mikhalych63/DAW00/daw00/daw00+analog.png

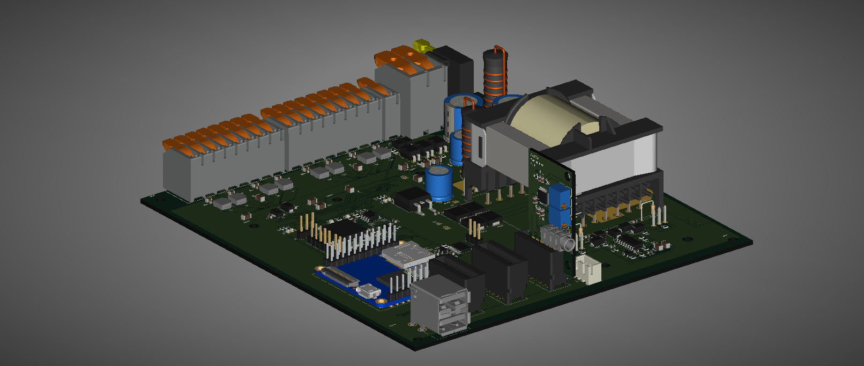
daw00/daw00+analog.png
