mikhalych63/DAW00/daw00/daw00+all.png

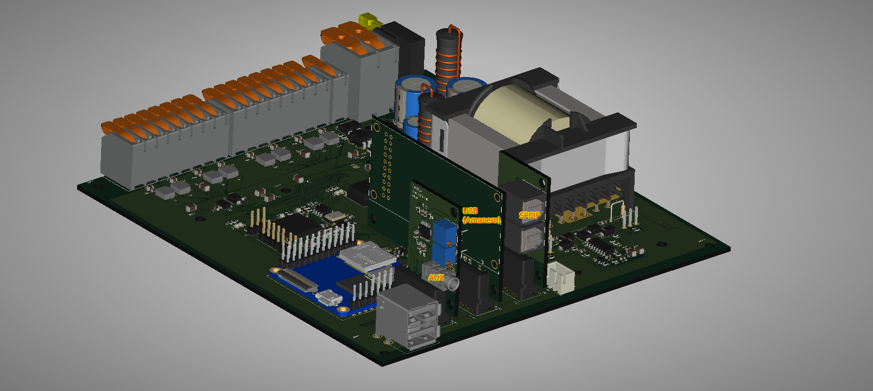
daw00/daw00+all.png
