mikhalych63/DAW00/daw00/daw00-3.png

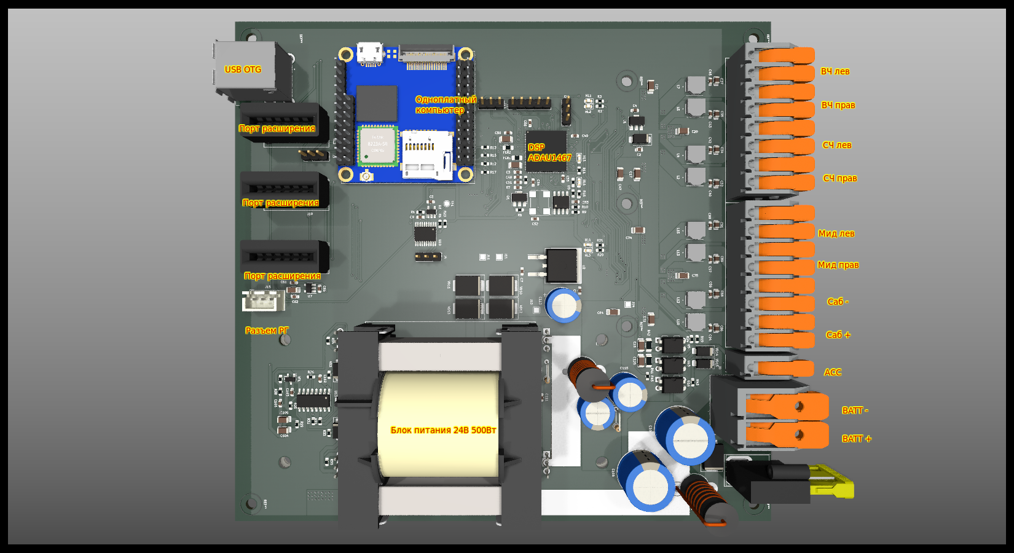
daw00/daw00-3.png
