mikhalych63/DAW00/daw00/daw00.1-2.png

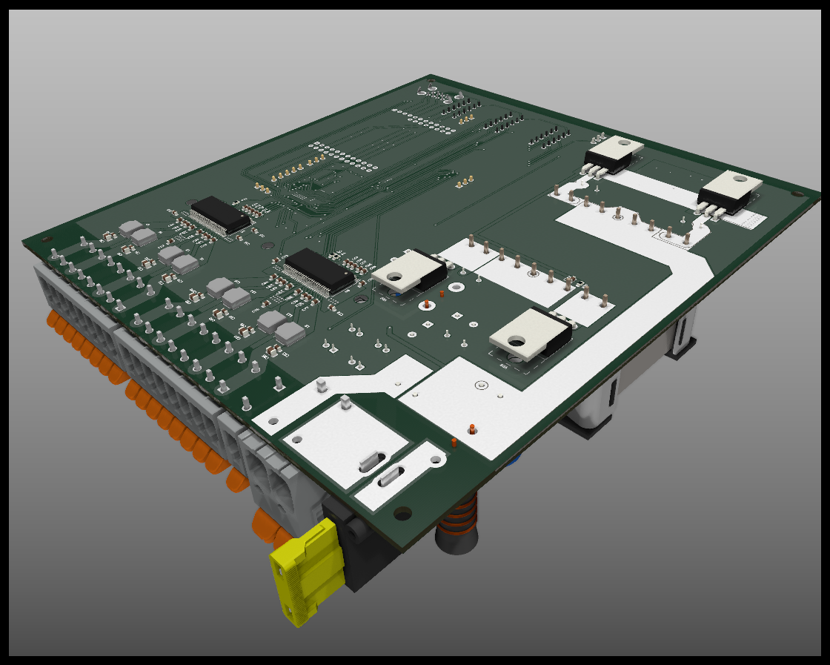
daw00/daw00.1-2.png
