mikhalych63/DAW00/daw00/daw00.png

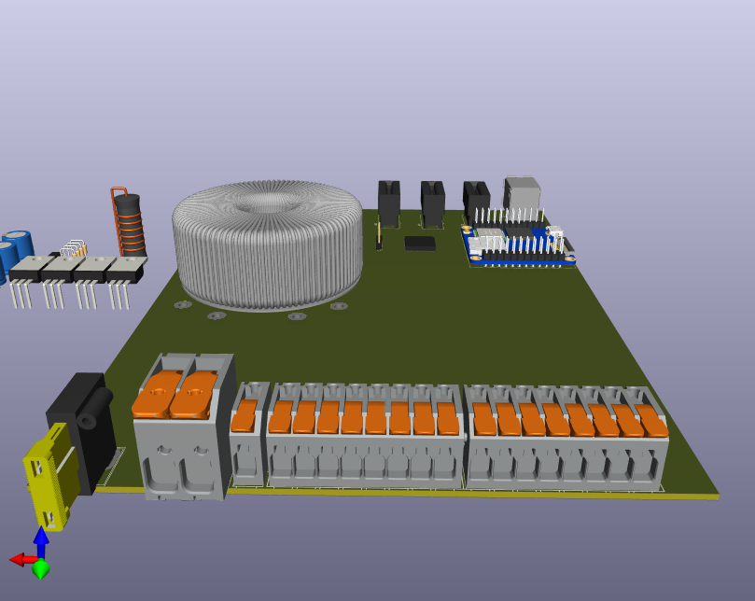
daw00/daw00.png
