mikhalych63/DAW00/daw00/enclosure/022_original.jpg

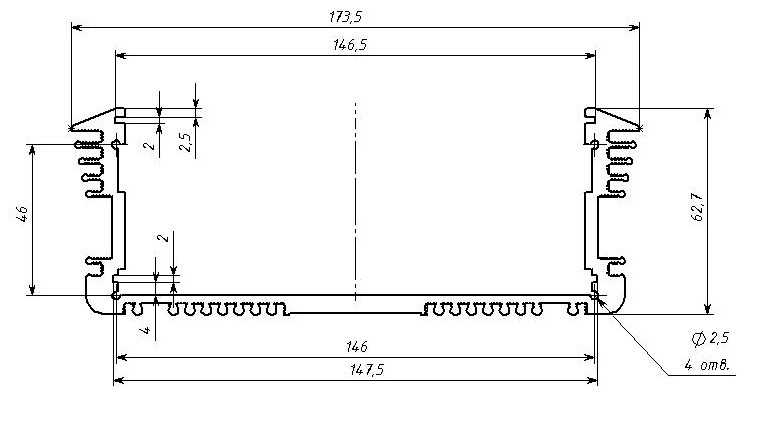
daw00/enclosure/022_original.jpg
