mikhalych63/DAW00/daw00/i2s_hdmi/I2S-HDMI.gif

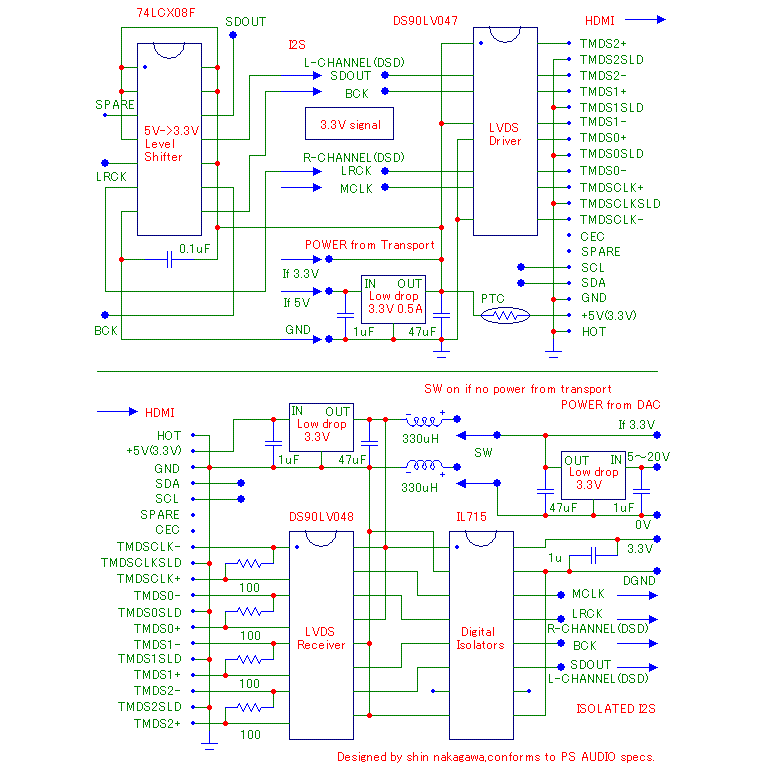
daw00/i2s_hdmi/I2S-HDMI.gif
