mikhalych63/DAW00/daw00/term.jpg

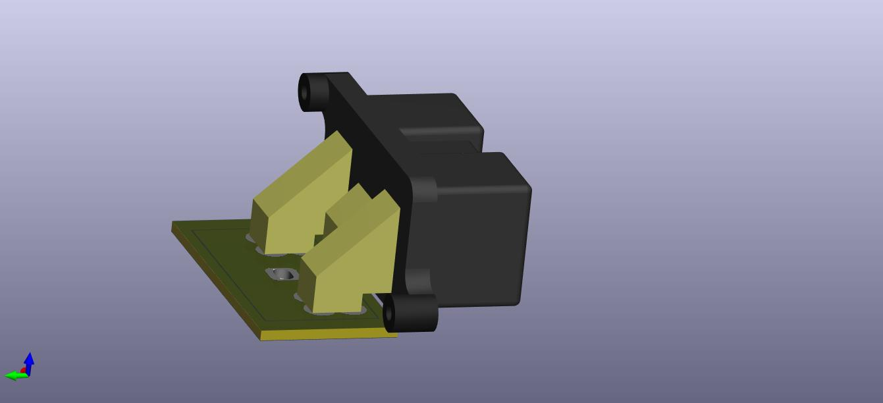
daw00/term.jpg
