mikhalych63/DAW00/daw00/Корпус1.png

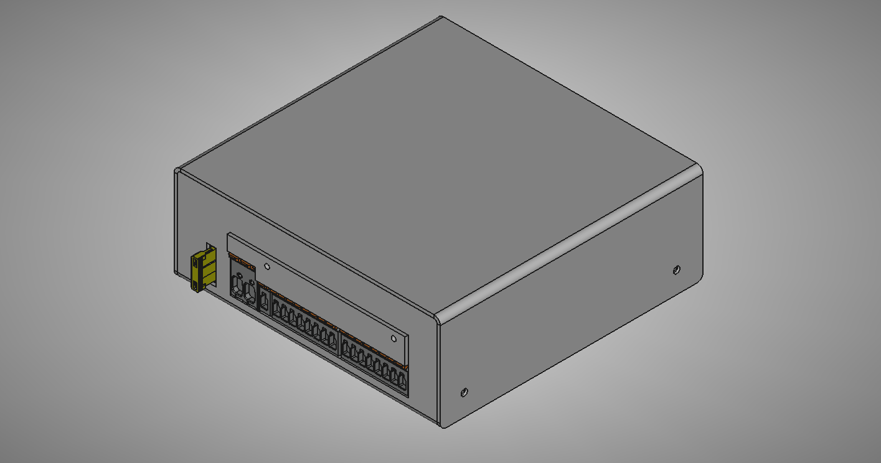
daw00/Корпус1.png
