mikhalych63/DAW00/daw00/Корпус2.png

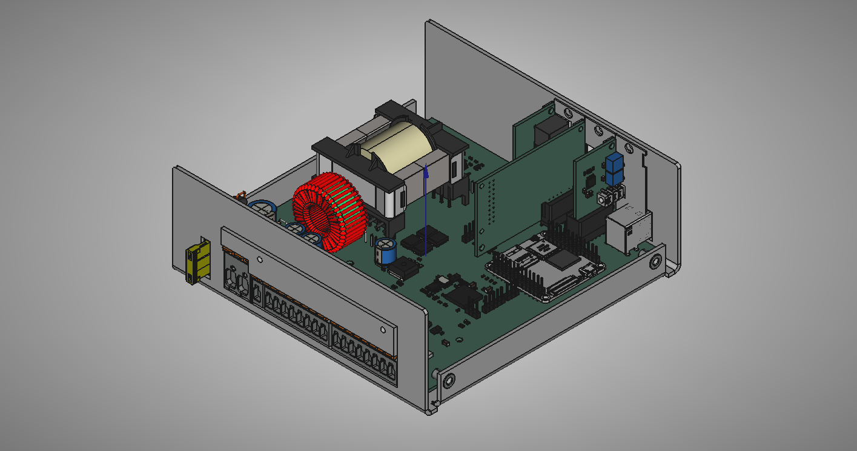
daw00/Корпус2.png
