mikhalych63/DAW00/daw00/Корпус3.png

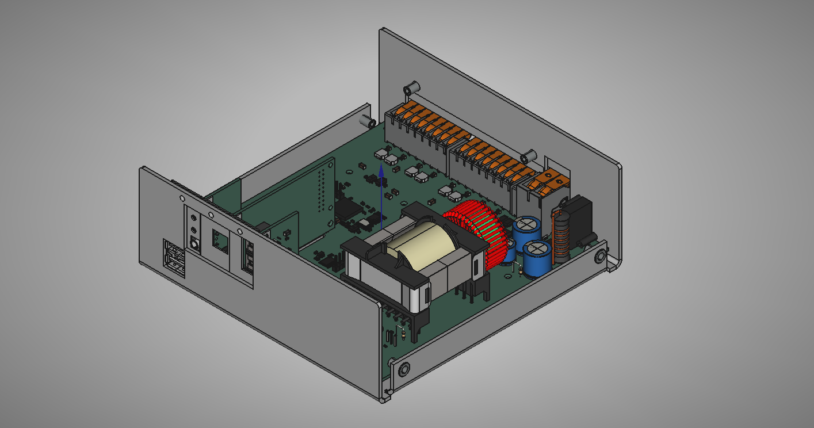
daw00/Корпус3.png
