mikhalych63/DAW00/daw00/Корпус 172*62.webp

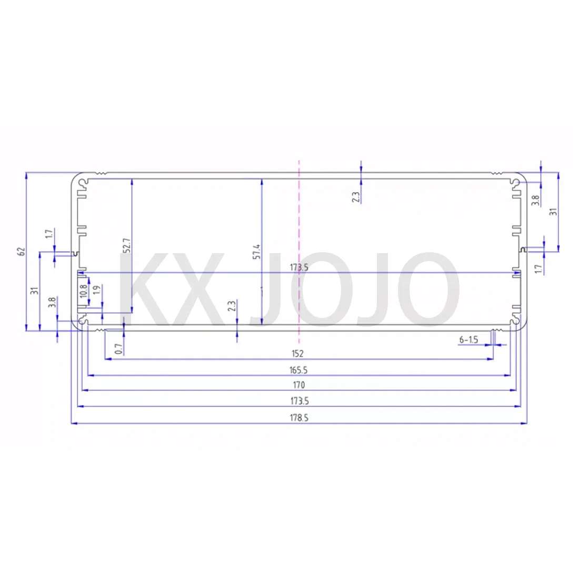
daw00/Корпус 172*62.webp
