mikhalych63/DAW00/daw00/bom/daw00.xlsx

Reference | Value | Footprint | Qty | Value1 | Цена | Сумма
C1,C6,C16,C17,C20,C21,C47,C63,C64,C71,C74,C75,C105,C125 | CAP_10u0_50V_X7R_1206 | Capacitor_SMD:C_1206_3216Metric | 14 | 10u | 5.2 | 72.8
C2,C7 | CAP_330n_50V_X7R_0603 | Capacitor_SMD:C_0603_1608Metric | 2 | 330n | 4 | 8
C3,C4,C5,C8,C9,C15,C18,C19,C22,C50,C53,C54,C55,C56,C57,C60,C62,C70,C72,C73,C76,C112 | CAP_100n_50V_X7R_0603 | Capacitor_SMD:C_0603_1608Metric | 22 | 100n | 2.5 | 55
C10,C11,C12,C13,C14,C23,C24,C25,C26,C27,C28,C29,C30,C31,C32,C33,C34,C35,C36,C37,C38,C65,C66,C67,C68,C69,C77,C78,C79,C80,C81,C82,C83,C84,C85,C86,C87,C88,C89,C90,C91,C92 | CAP_1u_50V_X7R_0603 | Capacitor_SMD:C_0603_1608Metric | 42 | 1u | 2.42 | 101.64
C39,C40,C41,C42,C43,C44,C45,C46,C49,C52,C61,C93,C94,C95,C96,C97,C98,C99,C100,C103,C106 | CAP_10n_50V_X7R_0603 | Capacitor_SMD:C_0603_1608Metric | 21 | 10n |  | 0
C48 | CAP_150p_50V_C0G_0603 | Capacitor_SMD:C_0603_1608Metric | 1 | 150p | 5 | 5
C51 | CAP_5n6_50V_X7R_0603 | Capacitor_SMD:C_0603_1608Metric | 1 | 5n6 | 5 | 5
C102,C111 | CAP_1n_50V_X7R_0603 | Capacitor_SMD:C_0603_1608Metric | 2 | 1n | 5 | 10
C104 | CAP_2u2_50V_X7R_1206 | Capacitor_SMD:C_1206_3216Metric | 1 | 2.2u | 5 | 5
C107,C108 | 2200μ | Capacitor_THT:CP_Radial_D14.0mm_P5.00mm | 2 | 2200u | 50 | 100
C109,C110 | CAP_22n_50V_X7R_0603 | Capacitor_SMD:C_0603_1608Metric | 2 | 22n | 5 | 10
C113,C114,C115 | CAP_330μ_35V | Capacitor_THT:CP_Radial_D10.0mm_P5.00mm | 3 | 330u | 30 | 90
F1 | Fuse | 00-mylib:Fuse_Blade_vertical | 1 |  | 170 | 170
FER1,FER2 | BLM21AG102SN1D | Resistor_SMD:R_0805_2012Metric_Pad1.20x1.40mm_HandSolder | 2 | 600R | 12 | 24
HL1,HL4 | LED_SMD_0603_YELLOW | LED_SMD:LED_0603_1608Metric | 2 |  | 15 | 30
HL2,HL3 | LED_SMD_0603_RED | LED_SMD:LED_0603_1608Metric | 2 |  | 15 | 30
HL5,HL6 | LED_SMD_0603_BLUE | LED_SMD:LED_0603_1608Metric_Pad1.05x0.95mm_HandSolder | 2 |  | 15 | 30
J2 | USB_A_Stacked | 00-mylib:USB_A_STACKED | 1 |  | 130 | 130
J6,J18 | DEGSON 2604 8x5 | Connector_Degson:DEGSON_8x5 | 2 |  | 130 | 260
J8 | DEGSON 2604 1x5 | Connector_Degson:DEGSON_1x5 | 1 |  | 30 | 30
J12,J19,J20 | Conn_edge_2x6_2.54_Male | Connector_Edge:2x6 | 3 |  | 100 | 300
J15 | Volume | Connector_JST:JST_XH_B3B-XH-A_1x03_P2.50mm_Vertical | 1 |  | 20 | 20
J22 | KF206-7.5-2P | Connector_Degson:DEGSON_2x7.5 | 1 |  | 160 | 160
L1,L2,L3,L4,L5,L6,L7,L8,L9,L10,L11,L12,L13,L14,L15,L16 | ETQP3M3R3KVP | my:SPM5010-5020 | 16 |  | 30 | 480
L18 | 5μ | my:L_Axial_L26.0mm_D9.0mm_P5.08mm_Vertical | 1 |  | 50 | 50
L19 | 25μ | 00-mylib:L_Toroid_Vertical_L33.0mm_W17.8mm_P12.70mm_Pulse_KM-5 | 1 |  | 50 | 50
Q1 | 2STF2360 | Package_TO_SOT_SMD:SOT-89-3 | 1 | 2STF2360 | 100 | 100
R1,R6,R23 | 10K | Resistor_SMD:R_0603_1608Metric | 3 |  | 1.5 | 4.5
R2,R3,R20,R21 | 1K | Resistor_SMD:R_0603_1608Metric | 4 |  | 1.5 | 6
R4,R5,R18,R22,R43 | 4.7K | Resistor_SMD:R_0603_1608Metric | 5 |  | 1.5 | 7.5
R7 | 4.3K | Resistor_SMD:R_0603_1608Metric | 1 | 4K3 | 1.5 | 1.5
R8,R24,R31,R32,R34,R35,R39,R45 | 1k | Resistor_SMD:R_0603_1608Metric | 8 | -- смешанные значения -- | 1.5 | 12
R9,R10,R11,R12,R13,R15,R17,R19 | 10k | Resistor_SMD:R_0603_1608Metric | 8 | -- смешанные значения -- | 1.5 | 12
R14,R16 | 510 | Resistor_SMD:R_0603_1608Metric | 2 | 510R | 1.5 | 3
R25 | 15k | Resistor_SMD:R_0603_1608Metric | 1 |  | 1.5 | 1.5
R26 | 150 | Resistor_SMD:R_0603_1608Metric | 1 |  | 1.5 | 1.5
R27 | 3k | Resistor_SMD:R_0603_1608Metric | 1 |  | 1.5 | 1.5
R28 | 3,6k | Resistor_SMD:R_0603_1608Metric | 1 |  | 1.5 | 1.5
R29,R30,R33 | 10 | Resistor_SMD:R_0603_1608Metric | 3 |  | 1.5 | 4.5
R36,R37 | 4.7 | Resistor_THT:R_Axial_DIN0204_L3.6mm_D1.6mm_P5.08mm_Vertical | 2 |  | 10 | 20
R38 | 100 | Resistor_THT:R_Axial_DIN0204_L3.6mm_D1.6mm_P5.08mm_Vertical | 1 |  | 10 | 10
R40 | 1.5k | Resistor_THT:R_Axial_DIN0204_L3.6mm_D1.6mm_P5.08mm_Vertical | 1 |  | 10 | 10
R41,R42 | 1.2k | Resistor_SMD:R_1206_3216Metric | 2 |  | 10 | 20
TR1 | TRANSF10 | 00-mylib:Transformer_ETD44_Horizontal | 1 |  | 500 | 500
U1 | L78L18_SOT89 | Package_TO_SOT_SMD:SOT-89-3 | 1 |  | 25 | 25
U2 | LD1086D2T33TR | Package_TO_SOT_SMD:TO-263-2 | 1 |  | 160 | 160
U3 | TPS3828-33DBVT | Package_TO_SOT_SMD:SOT-23-5 | 1 |  | 75 | 75
U4,U8 | TAS6424QDKQRQ1 | Package_SO:SSOP-56_7.5x18.5mm_P0.635mm | 2 |  | 300 | 600
U5,U15,U16 | TLP627 | Package_DIP:DIP-4_W7.62mm | 3 |  | 65 | 195
U6 | ADAU1467WBCPZ300RL | my:LFCSP-88-1EP_10x10mm_P0.5mm_EP6.15x6.15mm | 1 |  | 2500 | 2500
U7 | LP2985-5.0 | Package_TO_SOT_SMD:SOT-23-5 | 1 |  | 100 | 100
U9 | 25AA1024-I/SM | Package_SO:SOIC-8_3.9x4.9mm_P1.27mm | 1 | 25AA1024-I/SM | 500 | 500
U10 | STM32F030F4Px | Package_SO:TSSOP-20_4.4x6.5mm_P0.65mm | 1 |  | 75 | 75
U12 | Nanopi NEO Air | my:Nanopi NEO | 1 |  | 2500 | 2500
U13 | SG3525 | Package_SO:SOIC-16_3.9x9.9mm_P1.27mm | 1 |  | 50 | 50
VD1,VD10,VD11,VD12,VD13 | SS56 | Diode_SMD:D_SMC | 5 |  | 20 | 100
VD2 | ES1D | Diode_SMD:D_SMA | 1 |  | 15 | 15
VD3,VD4,VD5,VD14,VD15 | 1N5819 | Diode_SMD:D_SMA | 5 |  | 10 | 50
VD6,VD7 | 1N414E | Diode_SMD:D_SMA | 2 |  | 10 | 20
VD8,VD9 | MBR20100CT | Package_TO_SOT_THT:TO-220-3_Horizontal_TabUp | 2 |  | 30 | 60
VT1 | BC846 | Package_TO_SOT_SMD:SOT-23 | 1 |  | 20 | 20
VT2,VT3 | IRF3205 | Package_TO_SOT_THT:TO-220-3_Horizontal_TabUp | 2 |  | 35 | 70
X1 | SG-8002CA 24.5760M-PCBL3 | Oscillator:Oscillator_SMD_SeikoEpson_SG8002CA-4Pin_7.0x5.0mm | 1 |  | 350 | 350
Производство ПП |  |  | 1 |  | 800 | 800
Монтаж ПП |  |  | 1 |  | 2000 | 2000
Корпус |  |  | 1 |  | 2000 | 2000
 |  |  |  |  |  | 0
 |  |  |  |  |  | 15208.44
