mikhalych63/DAW00/daw00/amanero/amanero.step

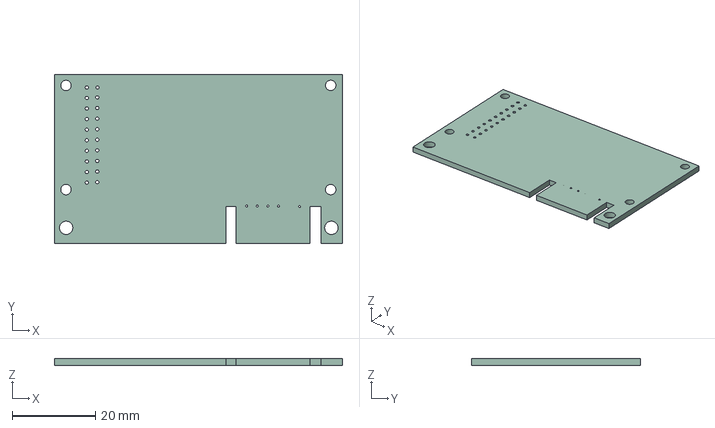
[picture p16: CAD file, 2024-03-14]
daw00/amanero/amanero.step
69.1 x 40.6 x 1.60 mm
