mikhalych63/DAW00/daw00/Enlosure/body.step

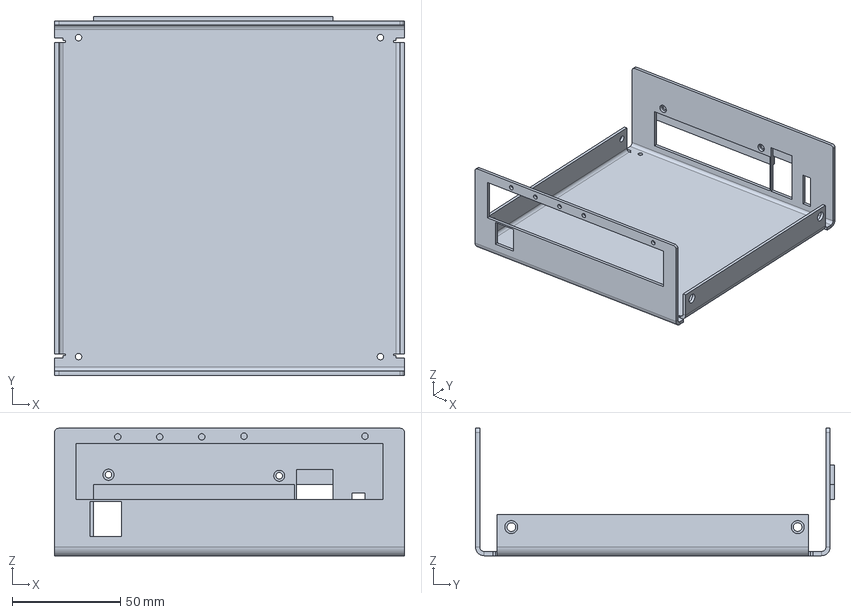
[picture p17: CAD file, 2024-03-20]
daw00/Enlosure/body.step
162.0 x 166.1 x 59.0 mm
