mikhalych63/DAW00/daw00/spdif/spdif.step

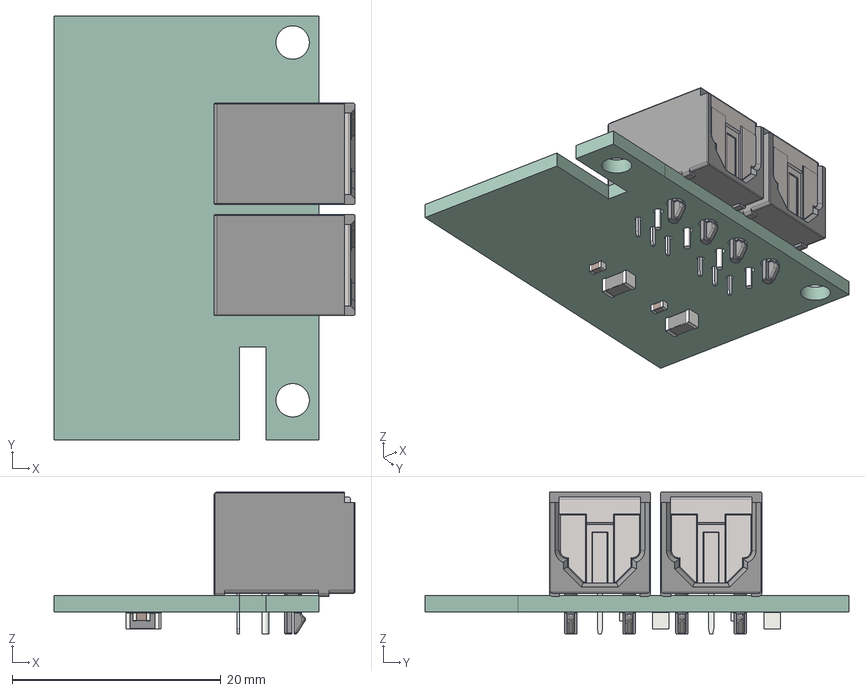
[picture p18: CAD file, 2024-03-20]
daw00/spdif/spdif.step
28.8 x 40.6 x 13.6 mm
User Library-TORX147PL(f,t) x 2
L_1206_3216Metric x 2
C_0603_1608Metric x 2
spdif_PCB
