mikhalych63/DAW00/daw00/daw00.FCStd

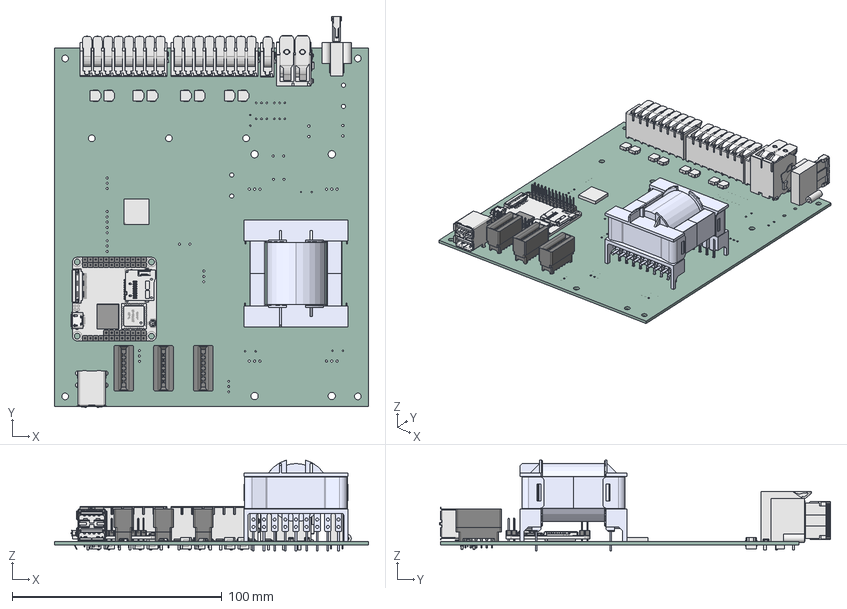
[picture p19: CAD file, 2024-02-22]
daw00/daw00.FCStd
149.9 x 186.7 x 43.4 mm
Tube001
Tube
Нога2
Нога1
Куб
fuse_automotive_10a001
fuse_automotive_10a
CAD_SPM5020-LR
ETD 44
ETD 045
ETD 046
ETD 047
ETD 048
ETD 049
ETD 050
ETD 051
ETD 052
ETD 053
ETD 054
ETD 055
ETD 056
ETD 057
ETD 058
ETD 059
ETD 060
ETD 061
ETD 062
ETD 063
ETD 064
ETD 065
ETD 066
ETD 067
CAD_SPM5020-LR001
CAD_SPM5020-LR002
CAD_SPM5020-LR003
C-5787745-4
CAD_SPM5020-LR004
CAD_SPM5020-LR005
NanoPi-NEO-Air-ASSY
NanoPi-NEO-Air-ASSY001
NanoPi-NEO-Air-ASSY002
NanoPi-NEO-Air-ASSY003
NanoPi-NEO-Air-ASSY004
NanoPi-NEO-Air-ASSY005
NanoPi-NEO-Air-ASSY006
NanoPi-NEO-Air-ASSY007
NanoPi-NEO-Air-ASSY008
NanoPi-NEO-Air-ASSY009
NanoPi-NEO-Air-ASSY010
NanoPi-NEO-Air-ASSY011
NanoPi-NEO-Air-ASSY012
NanoPi-NEO-Air-ASSY013
NanoPi-NEO-Air-ASSY014
NanoPi-NEO-Air-ASSY015
NanoPi-NEO-Air-ASSY016
NanoPi-NEO-Air-ASSY017
NanoPi-NEO-Air-ASSY018
NanoPi-NEO-Air-ASSY019
NanoPi-NEO-Air-ASSY020
NanoPi-NEO-Air-ASSY021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
