mikhalych63/DAW00/daw00/Enlosure/cap.step

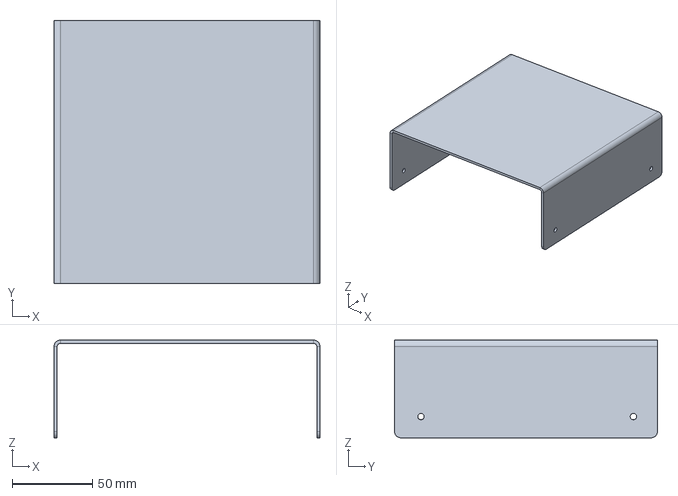
[picture p20: CAD file, 2024-03-20]
daw00/Enlosure/cap.step
166.0 x 164.0 x 61.0 mm
