mikhalych63/DAW00/(list of files, cad)

Other CAD files:
daw00/1.FCStd
daw00/analog_input/analog-input.FCStd
daw00/Enlosure/body.FCStd
daw00/Enlosure/body.SLDPRT
daw00/Enlosure/cap.FCStd
daw00/Enlosure/cap.SLDPRT
