mikhalych63/DAW00/daw00/daw00.kicad_pcb

## KiCad design daw00/daw00.kicad_pcb (2024-03-20)

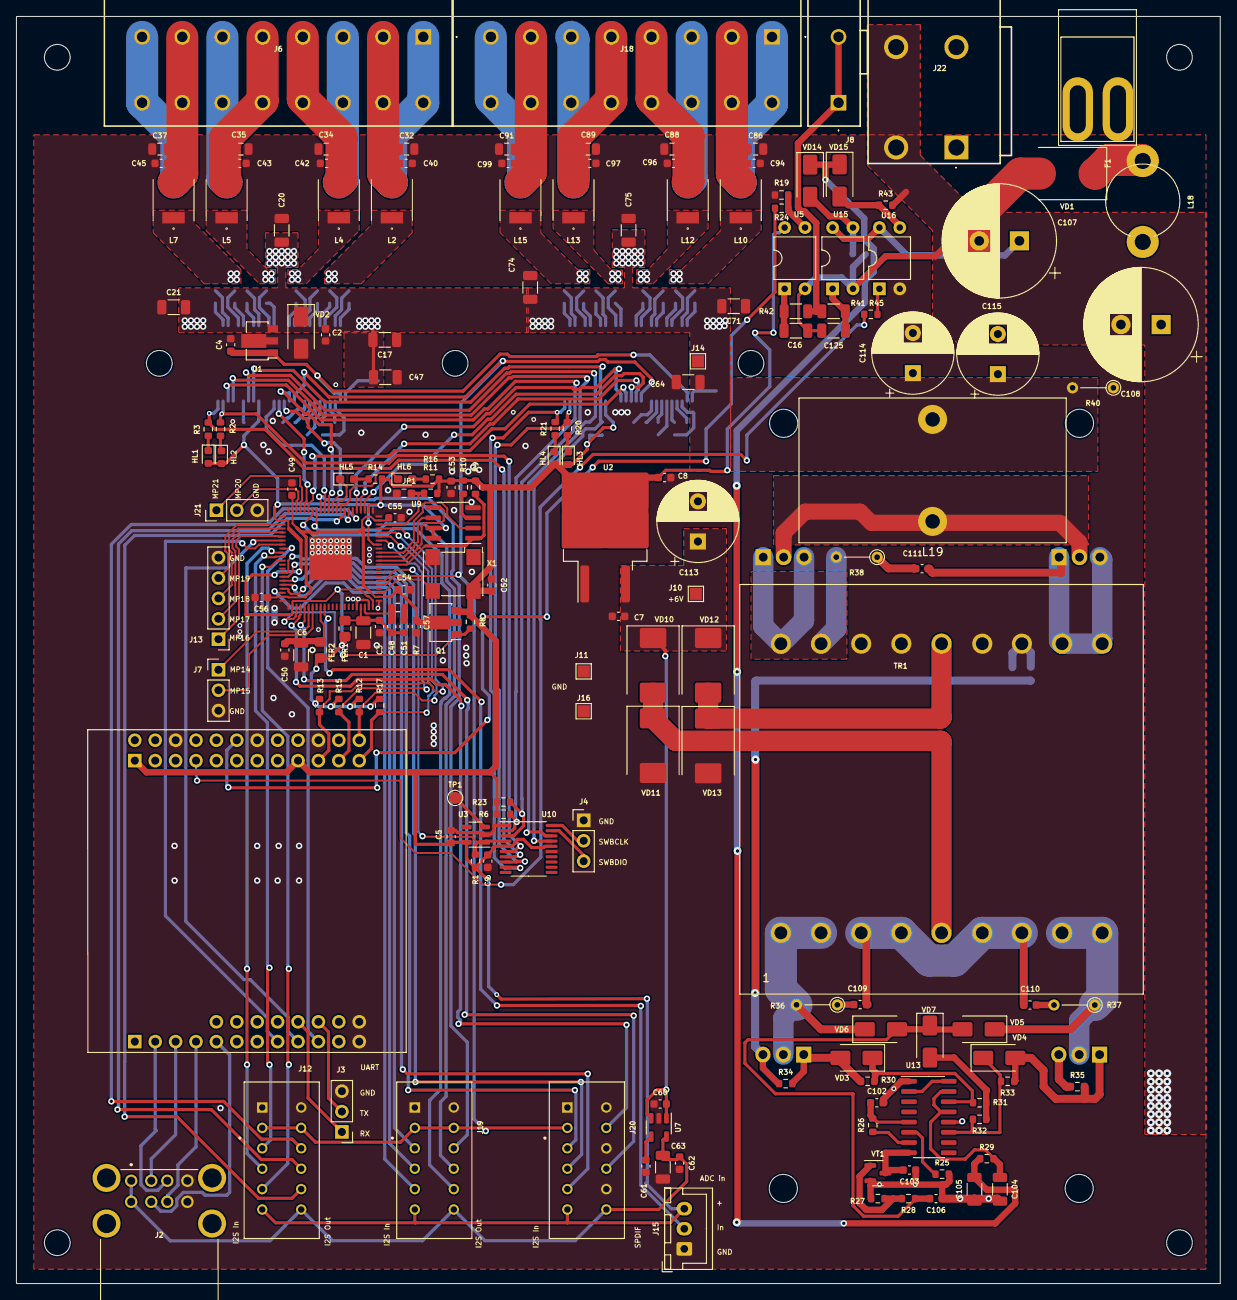
[picture p21: board daw00.kicad_pcb from above]

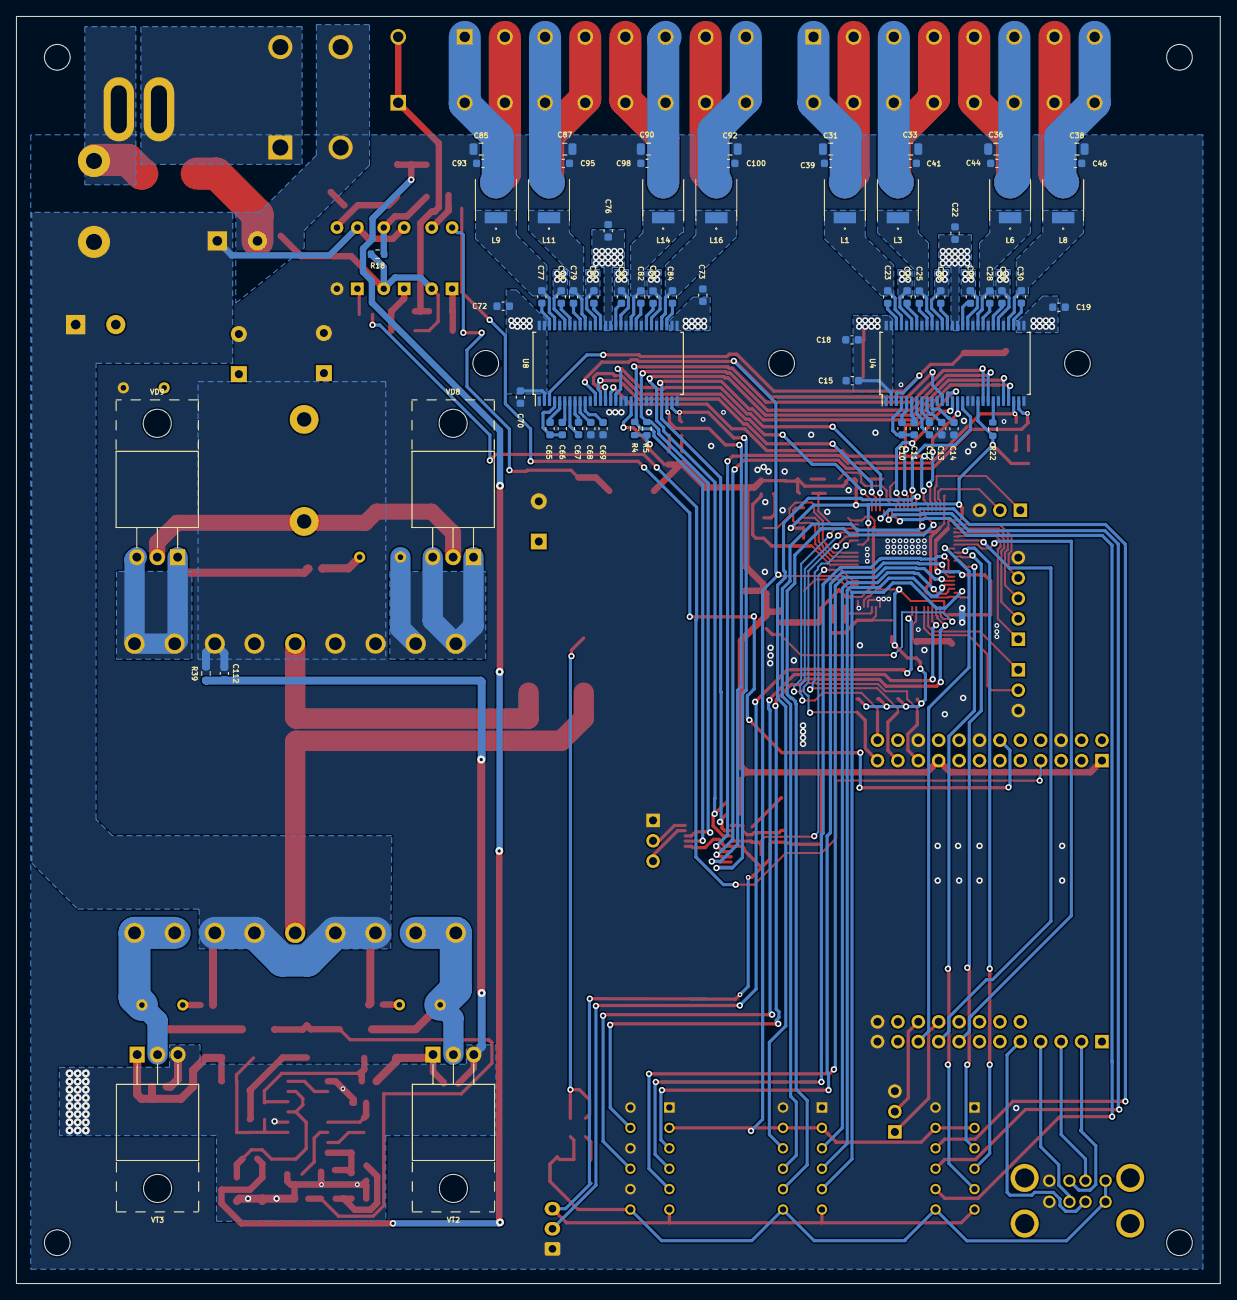
[picture p22: board daw00.kicad_pcb from below]

Board: 2 copper layers, 149.9 x 157.7 mm, 239 parts (70 on the bottom side), 188 nets.

Parts:
C1, C6, C16, C105, C125: CAP_10u0_50V_X7R_1206; C_1206_3216Metric
C2, C7: 0,33uF; C_0603_1608Metric
C3, C5, C50, C53, C54, C55, C56, C57, C112: CAP_100n_50V_X7R_0603; C_0603_1608Metric
C4, C8, C9, C15, C18, C19, C22, C60, C62, C70, C72, C73, C76: 100n; C_0603_1608Metric
C10, C11, C12, C13, C14, C23, C24, C25, C26, C27, C28, C29, C30, C65, C66, C67, C68, C69, C77, C78, C79, C80, C81, C82, C83, C84: 1,0uF; C_0603_1608Metric
C17, C20, C21, C47, C63, C64, C71, C74, C75: 10,0uF; C_1206_3216Metric
C31, C32, C33, C34, C35, C36, C37, C38, C85, C86, C87, C88, C89, C90, C91, C92: 1.0uF; C_0805_2012Metric
C39, C40, C41, C42, C43, C44, C45, C46, C61, C93, C94, C95, C96, C97, C98, C99, C100: 10n; C_0603_1608Metric
C48: CAP_150p_50V_C0G_0603; C_0603_1608Metric
C49, C103, C106: CAP_10n_50V_X7R_0603; C_0603_1608Metric
C51: CAP_5n6_50V_X7R_0603; C_0603_1608Metric
C52: CAP_10n_25V_X7R_0603; C_0603_1608Metric
C102, C111: CAP_1n_50V_X7R_0603; C_0603_1608Metric
C104: CAP_2u2_50V_X7R_1206; C_1206_3216Metric
C107, C108: 2200μ; CP_Radial_D14.0mm_P5.00mm
C109, C110: CAP_22n_50V_X7R_0603; C_0603_1608Metric
C113, C114, C115: 330μ; CP_Radial_D10.0mm_P5.00mm
F1: Fuse; Fuse_Blade_vertical
FER1, FER2: BLM21AG102SN1D; R_0805_2012Metric_Pad1.20x1.40mm_HandSolder
HL1, HL4: LED_SMD_0603_YELLOW; LED_0603_1608Metric
HL2, HL3: LED_SMD_0603_RED; LED_0603_1608Metric
HL5, HL6: LED_SMD_0603_BLUE; LED_0603_1608Metric_Pad1.05x0.95mm_HandSolder
J2: USB_A_Stacked; USB_A_STACKED
J3: UART; PinHeader_1x03_P2.54mm_Vertical
J4: SWD; PinHeader_1x03_P2.54mm_Vertical
J6, J18: DEGSON 2604 8x5; DEGSON_8x5
J7, J21: Conn_01x02_Male; PinHeader_1x03_P2.54mm_Vertical
J8: DEGSON 2604 1x5; DEGSON_1x5
J10: +6V; TestPoint_Pad_1.5x1.5mm
J11, J16: GND; TestPoint_Pad_1.5x1.5mm
J12, J19, J20: Conn_edge_2x6_2.54_Male; 2x6
J13: Conn_01x04_Male; PinHeader_1x05_P2.54mm_Vertical
J14: +24V; TestPoint_Pad_1.5x1.5mm
J15: Volume; JST_XH_B3B-XH-A_1x03_P2.50mm_Vertical
J22: KF206-7.5-2P; DEGSON_2x7.5
JP1: CON_JUMPER; R_0603_1608Metric_Pad0.98x0.95mm_HandSolder
L1, L2, L3, L4, L5, L6, L7, L8, L9, L10, L11, L12, L13, L14, L15, L16: 3.3uH; SPM5010-5020
L18: 5μ; L_Axial_L26.0mm_D9.0mm_P5.08mm_Vertical
L19: 25μ; L_Toroid_Vertical_L33.0mm_W17.8mm_P12.70mm_Pulse_KM-5
Q1: 2STF2360; SOT-89-3
R1, R6, R23: 10K; R_0603_1608Metric
R2, R3, R20, R21: 1K; R_0603_1608Metric
R4, R5, R22: 4k7; R_0603_1608Metric
R7: RES_4K3_1%_0.125W_Thick_0603; R_0603_1608Metric
R8: RES_1K0_1%_0.125W_Thick_0603; R_0603_1608Metric
R9, R10, R11, R12, R13, R15, R17: RES_10K0_1%_0.125W_Thick_0603; R_0603_1608Metric
R14, R16: RES_51R0_1%_0.125W_Thick_0603; R_0603_1608Metric
R18, R43: 4.7k; R_0603_1608Metric
R19: 10k; R_0603_1608Metric
R24, R31, R32, R34, R35, R39, R45: 1k; R_0603_1608Metric
R25: 15k; R_0603_1608Metric
R26: 150; R_0603_1608Metric
R27: 3k; R_0603_1608Metric
R28: 3,6k; R_0603_1608Metric
R29, R30, R33: 10; R_0603_1608Metric
R36, R37: 4.7; R_Axial_DIN0204_L3.6mm_D1.6mm_P5.08mm_Vertical
R38: 100; R_Axial_DIN0204_L3.6mm_D1.6mm_P5.08mm_Vertical
R40: 1.5k; R_Axial_DIN0204_L3.6mm_D1.6mm_P5.08mm_Vertical
R41, R42: 1.2k; R_1206_3216Metric
TP1: Reset; TestPoint_Pad_D1.5mm
TR1: TRANSF10; Transformer_ETD44_Horizontal
U1: L78L18_SOT89; SOT-89-3
U2: LD1086D2T33TR; TO-263-2
U3: TPS3828-33DBVT; SOT-23-5
U4, U8: TAS6424QDKQRQ1; SSOP-56_7.5x18.5mm_P0.635mm
U5, U15, U16: TLP627; DIP-4_W7.62mm
U6: ADAU1467WBCPZ300RL; LFCSP-88-1EP_10x10mm_P0.5mm_EP6.15x6.15mm
U7: LP2985-5.0; SOT-23-5
U9: 25AA1024-I/SM; SOIC-8_3.9x4.9mm_P1.27mm
U10: STM32F030F4Px; TSSOP-20_4.4x6.5mm_P0.65mm
U12: Nanopi NEO Air; Nanopi NEO
U13: SG3525; SOIC-16_3.9x9.9mm_P1.27mm
VD1, VD10, VD11, VD12, VD13: SS56; D_SMC
VD2: ES1D; D_SMA
VD3, VD4, VD5, VD14, VD15: 1N5819; D_SMA
VD6, VD7: 1N414E; D_SMA
VD8, VD9: MBR20100CT; TO-220-3_Horizontal_TabUp
VT1: BC846; SOT-23
VT2, VT3: IRF3205; TO-220-3_Horizontal_TabUp
X1: SG-8002CA 24.5760M-PCBL3; Oscillator_SMD_SeikoEpson_SG8002CA-4Pin_7.0x5.0mm

Connections:
+3V3: C5.2, C8.1, C9.2, C52.1, C53.1, FER1.2, FER2.2, HL1.2 (A), HL2.2 (A), HL3.2 (A), HL4.2 (A), J12.11, J15.3, J19.11, J20.11, Q1.3 (E), R1.1, R4.1, R5.1, R6.1, R8.2, R9.1, R10.1, R11.1, R12.1, R13.1, R14.1, R15.1, R16.1, R17.1, R22.2, R23.1, U2.2 (OUT), U3.5 (VDD), U4.19 (VDD), U5.4, U6.2 (IOVDD), U6.22 (IOVDD), U6.37 (IOVDD), U6.46 (IOVDD), U6.68 (IOVDD), U8.19 (VDD), U9.7 (~HOLD), U9.8 (VCC), U10.5 (VDDA), U10.16 (VDD), U12.1 (VDD_3.3V), U12.17 (VDD_3.3V), X1.4 (Vcc)
+5V: C62.2, C63.1, J2.1 (VBUS1), J2.5 (VBUS2), J12.12, J19.12, J20.12, U7.5 (VOUT)
+6V: C7.1, C60.2, C113.1, J10.1, U2.3 (IN), U7.1 (VIN), U7.3 (ON/~OFF), VD10.1 (K), VD12.1 (K)
+BATT: F1.1, J22.1
/Amplifier/AUXADC0: J15.2, U6.10 (AUXADC0)
/Amplifier/BCLKIN1: J12.7, U6.76 (BCLK_IN1)
/Amplifier/BCLKIN2: J20.7, U6.81 (BCLK_IN2)
/Amplifier/BCLKIN3: J19.7, U6.84 (BCLK_IN3)
/Amplifier/BCLKOUT0: U6.48 (BCLK_OUT0), U8.13 (SCLK)
/Amplifier/BCLKOUT1: J12.8, U6.51 (BCLK_OUT1)
/Amplifier/BCLKOUT2: U4.13 (SCLK), U6.56 (BCLK_OUT2)
/Amplifier/BCLKOUT3: J19.8, U6.59 (BCLK_OUT3)
/Amplifier/LRCKIN1: J12.5, U6.77 (LRCLK_IN1/MP11)
/Amplifier/LRCKIN2: J20.5, U6.82 (LRCLK_IN2/MP12)
/Amplifier/LRCKIN3: J19.5, U6.85 (LRCLK_IN3/MP13)
/Amplifier/LRCKOUT1: J12.6, U6.50 (LRCLK_OUT1/MP5)
/Amplifier/LRCKOUT3: J19.6, U6.58 (LRCLK_OUT3/MP9)
/Amplifier/LRCLKOUT0: U6.47 (LRCLK_OUT0/MP4), U8.14 (FSYNC)
/Amplifier/LRCLKOUT2: U4.14 (FSYNC), U6.55 (LRCLK_OUT2/MP8)
/Amplifier/SDATAIN1: J12.9, U6.78 (SDATA_IN1)
/Amplifier/SDATAIN2: J20.9, U6.83 (SDATA_IN2)
/Amplifier/SDATAIN3: J19.9, U6.86 (SDATA_IN3)
/Amplifier/SDATAOUT0: U6.49 (SDATA_OUT0), U8.16 (SDIN2)
/Amplifier/SDATAOUT1: J12.10, U6.52 (SDATA_OUT1)
/Amplifier/SDATAOUT1+: U6.61 (SDATAIO7/MP23), U8.15 (SDIN1)
/Amplifier/SDATAOUT2: U4.16 (SDIN2), U6.57 (SDATA_OUT2)
/Amplifier/SDATAOUT3: J19.10, U6.60 (SDATA_OUT3)
/Amplifier/SDATAOUT3+: U4.15 (SDIN1), U6.62 (SDATAIO6/MP22)
/Amplifier/SPDIFIN: J20.4, U6.4 (SPDIFIN)
/Amplifier/SPDIFOUT: J20.8, U6.5 (SPDIFOUT)
/Computer/SBWTCK: J4.2, U10.20 (PA14)
/Computer/SBWTDIO: J4.3, U10.19 (PA13)
ACC: J8.1, R41.2, R42.2
ACC_IN: R24.2, U12.12 (GPIO_A6)
BCLKIN0: U6.73 (BCLK_IN0), U12.39 (I2S0_BCK)
FAULT0: R21.2, U8.27 (FAULT), U10.9 (PA3)
FAULT1: R3.2, U4.27 (FAULT), U10.7 (PA1)
GND: C1.2, C2.2, C3.2, C4.2, C5.1, C6.2, C7.2, C8.2, C9.1, C13.2, C14.2, C15.1, C17.1, C18.1, C19.1, C20.2, C21.1, C22.2, C31.1, C32.2, C33.1, C34.2, C35.1, C36.2, C37.1, C38.2, C39.1, C40.2, C41.1, C42.2, C43.1, C44.2, C45.1, C46.2, C47.1, C49.2, C50.2, C52.2, C53.2, C54.2, C55.2, C56.2, C57.2, C60.1, C61.1, C62.1, C63.2, C64.1, C68.2, C69.2, C70.1, C71.1, C72.1, C73.1, C74.2, C75.1, C76.2, C85.1, C86.2, C87.1, C88.2, C89.1, C90.2, C91.1, C92.2, C93.1, C94.2, C95.1, C96.2, C97.1, C98.2, C99.1, C100.2, C112.1, C113.2, C114.2, C115.2, J2.4 (GND1), J2.8 (GND2), J3.3, J4.1, J7.3, J11.1, J12.1, J12.2, J13.5, J15.1, J16.1, J19.1, J19.2, J20.1, J20.2, J20.6, J20.10, J21.3, JP1.2, R19.2, R39.2, R40.1, TR1.6, TR1.7, U1.2 (GND), U2.1 (ADJ/GND), U3.2 (GND), U4.1 (GND), U4.11 (GND), U4.17 (GND), U4.18 (GND), U4.23 (I2C_ADDR1), U4.28 (GND), U4.33 (GND), U4.36 (GND), U4.39 (GND), U4.46 (GND), U4.49 (GND), U4.52 (GND), U6.1 (DGND), U6.8 (AGND), U6.18 (PGND), U6.21 (DGND), U6.23 (DGND), U6.29 (DGND), U6.36 (DGND), U6.44 (DGND), U6.45 (DGND), U6.66 (DGND), U6.67 (DGND), U6.88 (DGND), U6.89 (GND), U7.2 (GND), U8.1 (GND), U8.11 (GND), U8.17 (GND), U8.18 (GND), U8.22 (I2C_ADDR0), U8.23 (I2C_ADDR1), U8.28 (GND), U8.33 (GND), U8.36 (GND), U8.39 (GND), U8.46 (GND), U8.49 (GND), U8.52 (GND), U9.4 (VSS), U10.1 (BOOT0), U10.15 (VSS), U12.6 (GND), U12.14 (GND), U12.20 (GND), U12.42 (GND), U12.50 (GND), U16.2, VD2.2 (A), VD11.2 (A), VD13.2 (A), X1.2 (GND)
GNDPWR: C16.2, C102.2, C103.1, C104.2, C105.2, C106.1, C107.2, C108.2, C112.2, C125.2, J22.2, R18.2, R25.2, R27.1, R34.1, R35.1, R39.1, R43.2, U5.2, U13.1 (INV), U13.12 (GND), U15.2, VD1.2 (A), VT1.2 (E), VT2.3 (S), VT3.3 (S)
LRCKIN0: U6.74 (LRCLK_IN0/MP10), U12.38 (I2S0_LRCK)
MCLK: J12.3, J12.4, J19.3, J19.4, J20.3, U4.12 (MCLK), U6.27 (CLKOUT), U8.12 (MCLK)
MISO: R15.2, U6.38 (MISO/SDA), U12.21 (SPI0_MISO)
MOSI: R13.2, U6.41 (SS/ADDR0), U12.19 (SPI0_MOSI)
Mute: R23.2, U4.24 (MUTE), U8.24 (MUTE), U10.3 (PF1)
unnamed: C13.1, U4.9 (GVDD)
unnamed: C14.1, U4.10 (GVDD)
unnamed: C16.1, R42.1, U5.1
unnamed: C51.2, R7.2
unnamed: C68.1, U8.9 (GVDD)
unnamed: C69.1, U8.10 (GVDD)
unnamed: C107.1, C108.1, C109.2, C110.1, L18.2, TR1.2, TR1.3, U15.4, U16.4
unnamed: C109.1, R36.1
unnamed: C110.2, R37.2
unnamed: C111.1, R38.1
unnamed: C125.1, R41.1, U15.1
unnamed: HL1.1 (K), R3.1
unnamed: HL2.1 (K), R2.2
unnamed: HL3.1 (K), R20.2
unnamed: HL4.1 (K), R21.1
unnamed: HL5.2 (A), R14.2
unnamed: HL5.1 (K), U6.54 (MP7)
unnamed: HL6.2 (A), R16.2
unnamed: HL6.1 (K), U6.53 (MP6)
unnamed: J2.3 (D1+), U12.32 (USB_DP1)
unnamed: J2.2 (D1-), U12.33 (USB_DM1)
unnamed: J2.7 (D2+), U12.34 (USB_DP2)
unnamed: J2.6 (D2-), U12.35 (USB_DM2)
unnamed: J3.1, U12.47 (UART0RX)
unnamed: J3.2, U12.48 (UART0TX)
unnamed: C31.2, C39.2, J6.1, L1.2
unnamed: C32.1, C40.1, J6.2, L2.2
unnamed: C33.2, C41.2, J6.3, L3.2
unnamed: C34.1, C42.1, J6.4, L4.2
unnamed: C35.2, C43.2, J6.5, L5.2
unnamed: C36.1, C44.1, J6.6, L6.2
unnamed: C37.2, C45.2, J6.7, L7.2
unnamed: C38.1, C46.1, J6.8, L8.2
unnamed: J7.1, U6.6 (MP14)
unnamed: J7.2, U6.7 (MP15)
unnamed: J13.1, U6.72 (SDATAIO0/MP16)
unnamed: J13.2, U6.71 (SDATAIO1/MP17)
unnamed: J13.3, U6.70 (SDATAIO2/MP18)
unnamed: J13.4, U6.69 (SDATAIO3/MP19)
unnamed: C85.2, C93.2, J18.1, L9.2
unnamed: C86.1, C94.1, J18.2, L10.2
unnamed: C87.2, C95.2, J18.3, L11.2
unnamed: C88.1, C96.1, J18.4, L12.2
unnamed: C89.2, C97.2, J18.5, L13.2
unnamed: C90.1, C98.1, J18.6, L14.2
unnamed: C91.2, C99.2, J18.7, L15.2
unnamed: C92.1, C100.1, J18.8, L16.2
unnamed: J21.1, U6.63 (SDATAIO5/MP21)
unnamed: J21.2, U6.64 (SDATAIO4/MP20)
unnamed: Q1.1 (B), R8.1, U6.3 (VDRIVE)
unnamed: R19.1, R24.1, U5.3
unnamed: R45.2, U16.1
unnamed: TP1.1, U3.3 (~MR)
unnamed: C10.2, C11.2, U4.4 (AREF)
unnamed: C12.1, U4.8 (AVDD)
unnamed: C12.2, U4.7 (AVSS)
unnamed: C29.2, U4.35 (BST+1P)
unnamed: C30.1, U4.31 (BST_1M)
unnamed: C28.1, U4.37 (BST_2M)
unnamed: C27.2, U4.41 (BST_2P)
unnamed: C26.1, U4.44 (BST_3M)
unnamed: C25.2, U4.48 (BST_3P)
unnamed: C24.1, U4.50 (BST_4M)
unnamed: C23.2, U4.54 (BST_4P)
unnamed: R22.1, U4.22 (I2C_ADDR0)
unnamed: C30.2, L8.1, U4.32 (OUT_1M)
unnamed: C29.1, L7.1, U4.34 (OUT_1P)
unnamed: C28.2, L6.1, U4.38 (OUT_2M)
unnamed: C27.1, L5.1, U4.40 (OUT_2P)
unnamed: C26.2, L4.1, U4.45 (OUT_3M)
unnamed: C25.1, L3.1, U4.47 (OUT_3P)
unnamed: C24.2, L2.1, U4.51 (OUT_4M)
unnamed: C23.1, L1.1, U4.53 (OUT_4P)
unnamed: C11.1, U4.6 (VCOM)
unnamed: C10.1, U4.5 (VREG)
unnamed: C6.1, C50.1, FER2.1, U6.9 (AVDD)
unnamed: U6.33 (MOSI_M/MP1), U9.5 (SI)
unnamed: C48.2, R7.1, U6.20 (PLLFILT)
unnamed: C1.1, C3.1, C48.1, C51.1, FER1.1, U6.19 (PVDD)
unnamed: U6.34 (SCL_M/SCLK_M/MP2), U9.6 (SCK)
unnamed: U6.35 (SDA_M/MISO_M/MP3), U9.2 (SO)
unnamed: JP1.1, R11.2, U6.42 (SELFBOOT)
unnamed: R9.2, U6.32 (SS_M/MP0), U9.1 (~CS)
unnamed: U6.25 (XTALIN/MCLK), X1.3 (OUT)
unnamed: C61.2, U7.4 (BP)
unnamed: C65.2, C66.2, U8.4 (AREF)
unnamed: C67.1, U8.8 (AVDD)
unnamed: C67.2, U8.7 (AVSS)
unnamed: C83.2, U8.35 (BST+1P)
unnamed: C84.1, U8.31 (BST_1M)
unnamed: C82.1, U8.37 (BST_2M)
unnamed: C81.2, U8.41 (BST_2P)
unnamed: C80.1, U8.44 (BST_3M)
unnamed: C79.2, U8.48 (BST_3P)
unnamed: C78.1, U8.50 (BST_4M)
unnamed: C77.2, U8.54 (BST_4P)
unnamed: C84.2, L16.1, U8.32 (OUT_1M)
unnamed: C83.1, L15.1, U8.34 (OUT_1P)
unnamed: C82.2, L14.1, U8.38 (OUT_2M)
unnamed: C81.1, L13.1, U8.40 (OUT_2P)
unnamed: C80.2, L12.1, U8.45 (OUT_3M)
unnamed: C79.1, L11.1, U8.47 (OUT_3P)
unnamed: C78.2, L10.1, U8.51 (OUT_4M)
unnamed: C77.1, L9.1, U8.53 (OUT_4P)
unnamed: C66.1, U8.6 (VCOM)
unnamed: C65.1, U8.5 (VREG)
unnamed: R10.2, U9.3 (~WP)
unnamed: C102.1, R26.2, U13.5 (CT)
unnamed: R26.1, U13.7 (DISCH)
unnamed: U13.2 (NI), U13.16 (REF)
unnamed: R32.2, R33.2, U13.11 (OUTA), VD4.1 (K)
unnamed: R30.2, R31.2, U13.14 (OUTB), VD3.1 (K)
unnamed: R25.1, U13.6 (RT)
unnamed: C103.2, U13.8 (SS), VT1.3 (C)
unnamed: C104.1, R29.2, U13.13 (VC), U13.15 (VIN)
unnamed: F1.2, L18.1, VD1.1 (K)
unnamed: R30.1, R34.2, VD3.2 (A), VT2.1 (G)
unnamed: R33.1, R35.2, VD4.2 (A), VT3.1 (G)
unnamed: R31.1, R32.1, VD5.2 (A)
unnamed: C106.2, R28.1, VD5.1 (K), VD6.2 (A), VD7.2 (A)
unnamed: R36.2, TR1.1, VD6.1 (K), VT2.2 (D)
unnamed: R37.1, TR1.4, VD7.1 (K), VT3.2 (D)
unnamed: R38.2, TR1.8, VD8.1 (A1), VD8.3 (A2)
unnamed: L19.1, VD8.2 (A), VD9.2 (A)
unnamed: C111.2, TR1.5, VD9.1 (A1), VD9.3 (A2)
unnamed: TR1.10, VD10.2 (A), VD11.1 (K)
unnamed: TR1.9, VD12.2 (A), VD13.1 (K)
unnamed: R18.1, U15.3, VD14.2 (A)
unnamed: C105.1, R29.1, VD14.1 (K), VD15.1 (K)
unnamed: R43.1, U16.3, VD15.2 (A)
unnamed: R27.2, R28.2, VT1.1 (B)
PVDD: C2.1, C15.2, C17.2, C18.2, C19.2, C20.1, C21.2, C22.1, C47.2, C64.2, C70.2, C71.2, C72.2, C73.2, C74.1, C75.2, C76.1, C114.1, C115.1, J14.1, L19.2, R40.2, U1.3 (IN), U4.2 (PVDD), U4.29 (PVDD), U4.30 (PVDD), U4.42 (PVDD), U4.43 (PVDD), U4.55 (PVDD), U4.56 (PVDD), U8.2 (PVDD), U8.29 (PVDD), U8.30 (PVDD), U8.42 (PVDD), U8.43 (PVDD), U8.55 (PVDD), U8.56 (PVDD), VD2.1 (K)
REMOTE: R45.1, U12.7 (GPIO_G11)
RST: R1.2, U3.1 (~RESET), U6.28 (RESET), U10.4 (NRST)
SCL: R4.2, U4.20 (SCL), U8.20 (SCL), U10.17 (PA9)
SCL: R17.2, U6.39 (SCLK/SCL), U12.23 (SPI0_CLK)
SDA: R5.2, U4.21 (SDA), U8.21 (SDA), U10.18 (PA10)
SDATAIN0: U6.75 (SDATA_IN0), U12.40 (I2S0_SDOUT)
SS: R12.2, U6.40 (MOSI/ADDR1), U12.24 (SPI0_CS)
Standby: R6.2, U4.25 (STANDBY), U8.25 (STANDBY), U10.2 (PF0)
VBAT: C4.1, U1.1 (OUT), U4.3 (VBAT), U8.3 (VBAT)
VPP: C49.1, C54.1, C55.1, C56.1, C57.1, Q1.2 (C), U6.24 (DVDD), U6.43 (DVDD), U6.65 (DVDD), U6.87 (DVDD)
WARN0: R20.1, U8.26 (WARN), U10.8 (PA2)
WARN1: R2.1, U4.26 (WARN), U10.6 (PA0)
