mikhalych63/DAW00/daw00/spdif/spdif.kicad_pcb

## KiCad design daw00/spdif/spdif.kicad_pcb (2024-03-20)

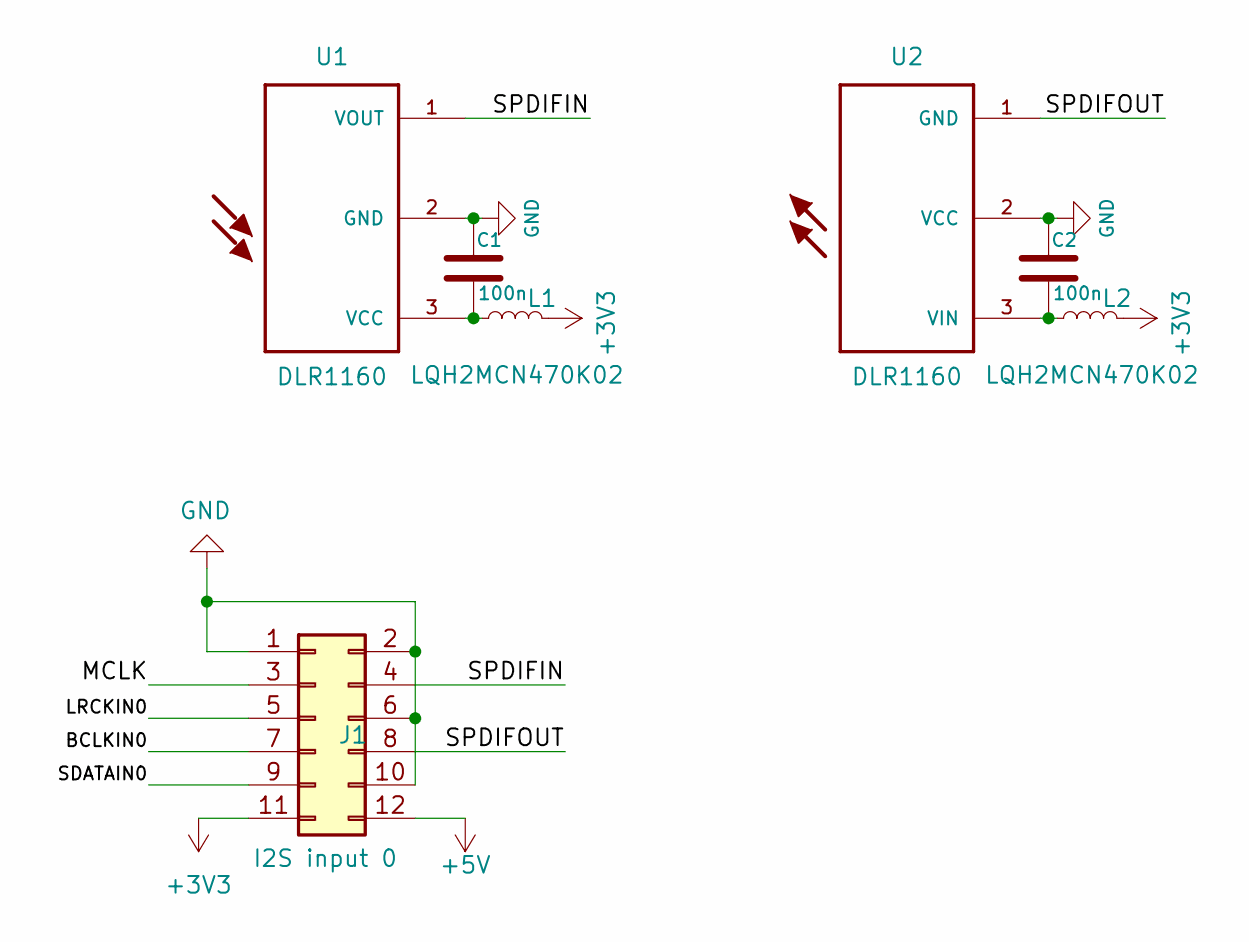
[picture p23: schematic spdif.kicad_sch]

Parts:
C1, C2: CAP_100n_25V_X7R_0603; C_0603_1608Metric
J1: Conn_01x06_Male; EDGE-2x6-2.54
L1, L2: LQH2MCN470K02; L_Murata_LQH2MCNxxxx02_2.0x1.6mm
U1, U2: DLR1160; Toslink

Connections:
+3V3: J1.11, L1.2, L2.2
+5V: J1.12
/BCLKIN0: J1.7
/LRCKIN0: J1.5
/MCLK: J1.3
/SDATAIN0: J1.9
/SPDIFIN: J1.4, U1.1 (VOUT)
/SPDIFOUT: J1.8, U2.1 (GND)
GND: C1.1, C2.1, J1.1, J1.2, J1.6, J1.10, U1.2 (GND), U1.NC1, U1.NC2, U2.2 (VCC), U2.NC1, U2.NC2
unnamed: C1.2, L1.1, U1.3 (VCC)
unnamed: C2.2, L2.1, U2.3 (VIN)

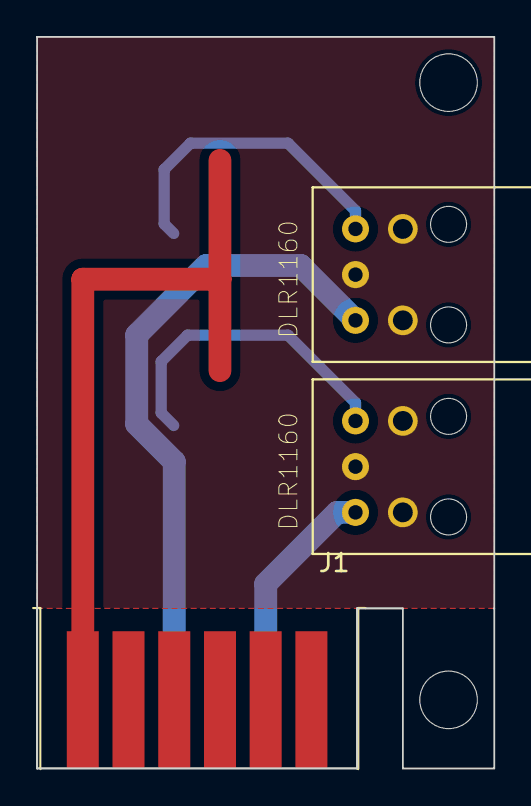
[picture p24: board spdif.kicad_pcb from above]

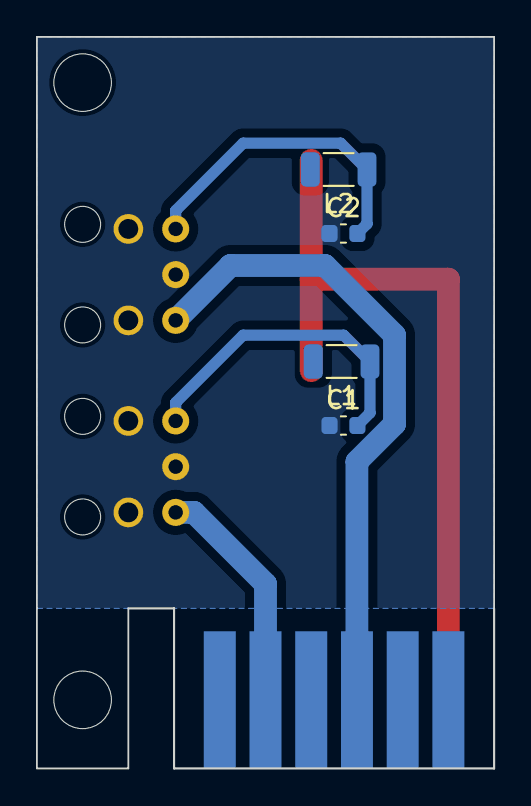
[picture p25: board spdif.kicad_pcb from below]

Board: 2 copper layers, 25.4 x 40.6 mm, 7 parts (4 on the bottom side), 6 nets.
