mikhalych63/DAW00/daw00/analog_input/analog_input.kicad_pcb

## KiCad design daw00/analog_input/analog_input.kicad_pcb (2024-03-14)

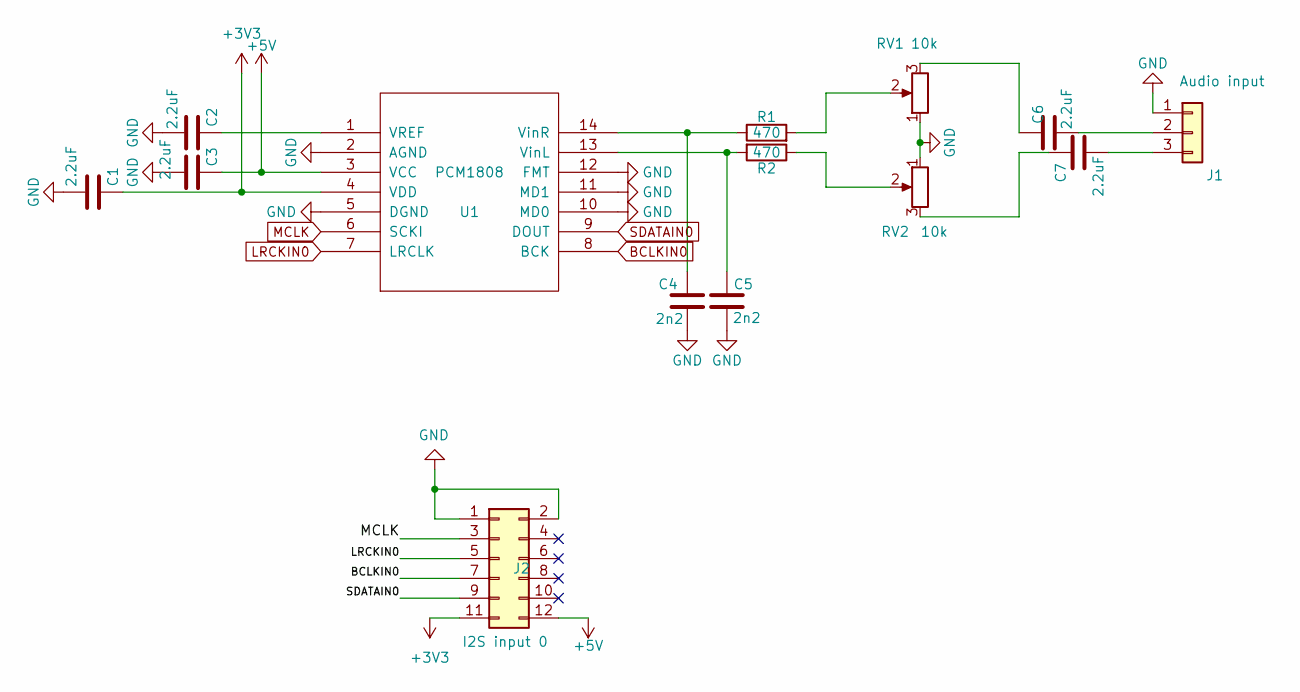
[picture p26: schematic analog_input.kicad_sch]

Parts:
C1, C2, C3, C6, C7: 2.2uF; C_0805_2012Metric
C4, C5: 2n2; C_0603_1608Metric
J1: Conn_01x03_Male; PJ313
J2: Conn_01x06_Male; EDGE-2x6-2.54
R1, R2: 470; R_0603_1608Metric
RV1, RV2: 10k; Potentiometer_Bourns_3266P_Horizontal
U1: PCM1808; TSSOP-14_4.4x5mm_P0.65mm

Connections:
+3V3: C1.1, J2.11, U1.4 (VDD)
+5V: C3.1, J2.12, U1.3 (VCC)
BCLKIN0: J2.7, U1.8 (BCK)
GND: C1.2, C2.2, C3.2, C4.1, C5.1, J1.1, J2.1, J2.2, RV1.1, RV2.1, U1.2 (AGND), U1.5 (DGND), U1.10 (MD0), U1.11 (MD1), U1.12 (FMT)
LRCKIN0: J2.5, U1.7 (LRCLK)
MCLK: J2.3, U1.6 (SCKI)
unnamed: C6.2, RV1.3
unnamed: C7.1, RV2.3
unnamed: C6.1, J1.2
unnamed: C7.2, J1.3
unnamed: R1.2, RV1.2
unnamed: R2.1, RV2.2
unnamed: C2.1, U1.1 (VREF)
unnamed: C5.2, R2.2, U1.13 (VinL)
unnamed: C4.2, R1.1, U1.14 (VinR)
SDATAIN0: J2.9, U1.9 (DOUT)

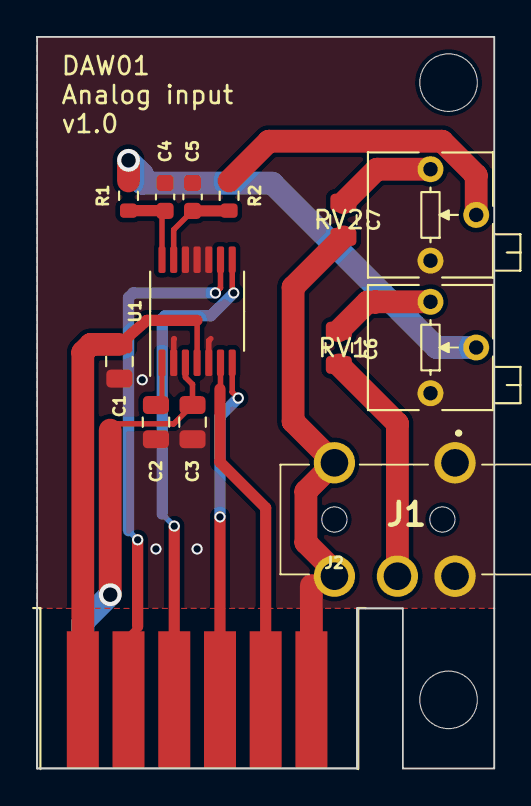
[picture p27: board analog_input.kicad_pcb from above]

Board: 2 copper layers, 25.4 x 40.6 mm, 14 parts (0 on the bottom side), 16 nets.
