mikhalych63/DAW00/daw00/amanero/amanero.kicad_pcb

## KiCad design daw00/amanero/amanero.kicad_pcb (2024-03-14)

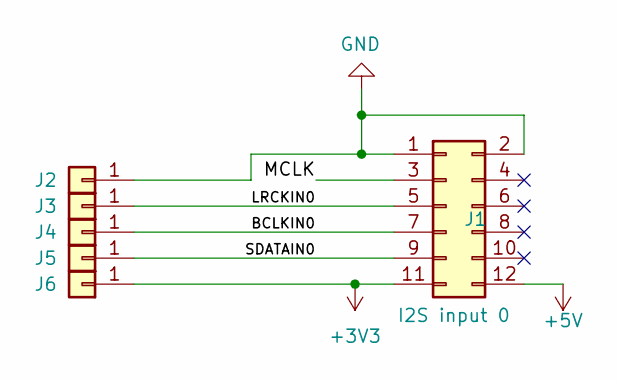
[picture p28: schematic amanero.kicad_sch]

Parts:
J1: Conn_01x06_Male; EDGE-2x6-2.54
J2, J3, J4, J5, J6: Conn_01x01; TestPoint_THTPad_1.0x1.0mm_Drill0.5mm

Connections:
+3V3: J1.11, J6.1
+5V: J1.12
/BCLKIN0: J1.7, J4.1
/LRCKIN0: J1.5, J3.1
/MCLK: J1.3
/SDATAIN0: J1.9, J5.1
GND: J1.1, J1.2, J2.1

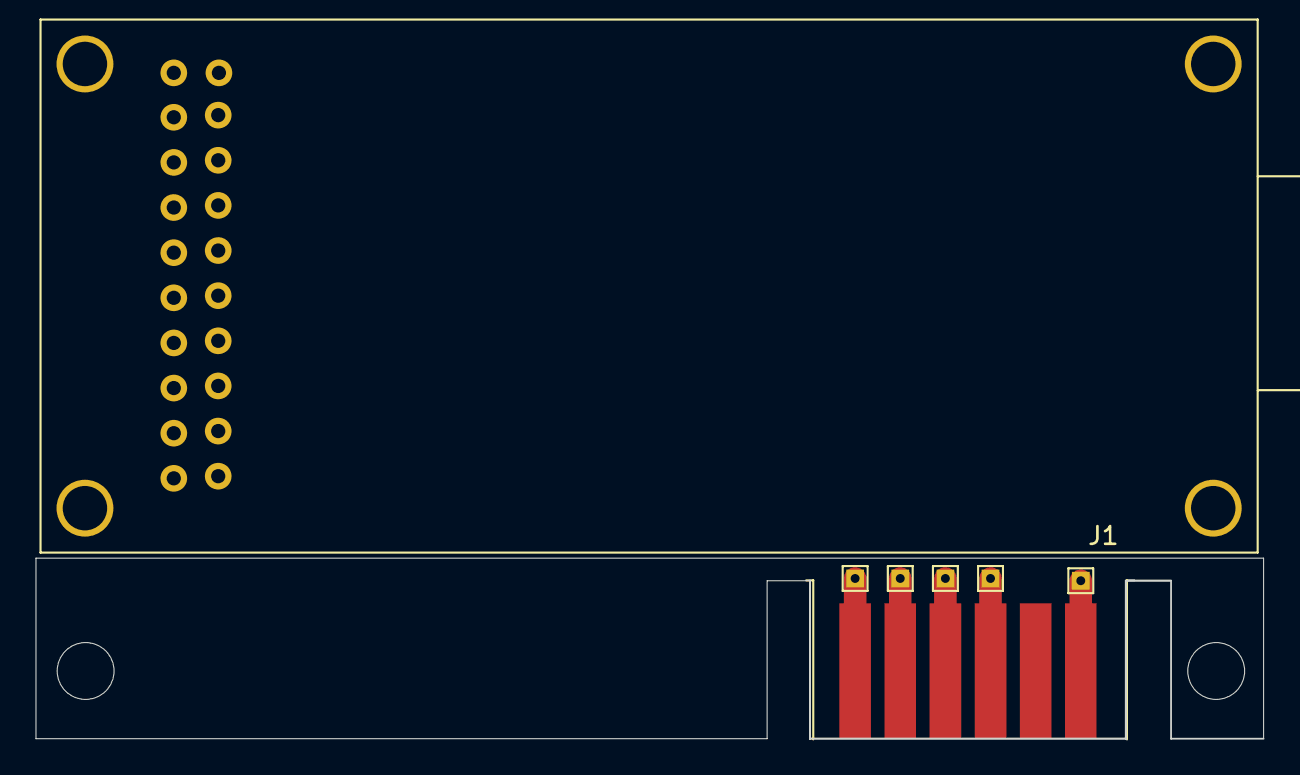
[picture p29: board amanero.kicad_pcb from above]

Board: 2 copper layers, 69.1 x 10.2 mm, 6 parts (0 on the bottom side), 5 nets.
