mikhalych63/DAW00/(commit log)

2024-01-30 Чтоб не потерялось
    [Amplifier.kicad_sch, analog_input.kicad_pcb, analog_input.kicad_sch, computer.kicad_sch, daw00.kicad_sch, power.kicad_sch, spdif.kicad_pcb, spdif.kicad_sch]
2024-02-14 Промежуточная
    [Amplifier.kicad_sch, computer.kicad_sch, daw00.FCStd, daw00.kicad_pcb, power.kicad_sch]
2024-02-22 Почти все
    [Amplifier.kicad_sch, computer.kicad_sch, daw00.FCStd, daw00.kicad_pcb, power.kicad_sch]
2024-02-29 Основная плата все
    [Amplifier.kicad_sch, bom_daw00.ods, computer.kicad_sch, daw00.kicad_pcb, daw00.kicad_sch, power.kicad_sch, test.kicad_pcb, test.kicad_sch]
2024-03-03 Добавил надписи
    [analog-input.FCStd, analog_input.kicad_pcb, analog_input.kicad_sch, daw00.kicad_pcb]
2024-03-20 Добавил корпус
    [1.FCStd, body.FCStd, body.SLDPRT, body.step, cap.FCStd, cap.SLDPRT, cap.step, daw00.kicad_pcb]
